JonathanGWesterfield/CSCE462/Project Files/AutoSpiel Images/JPG's/In Lab.jpg

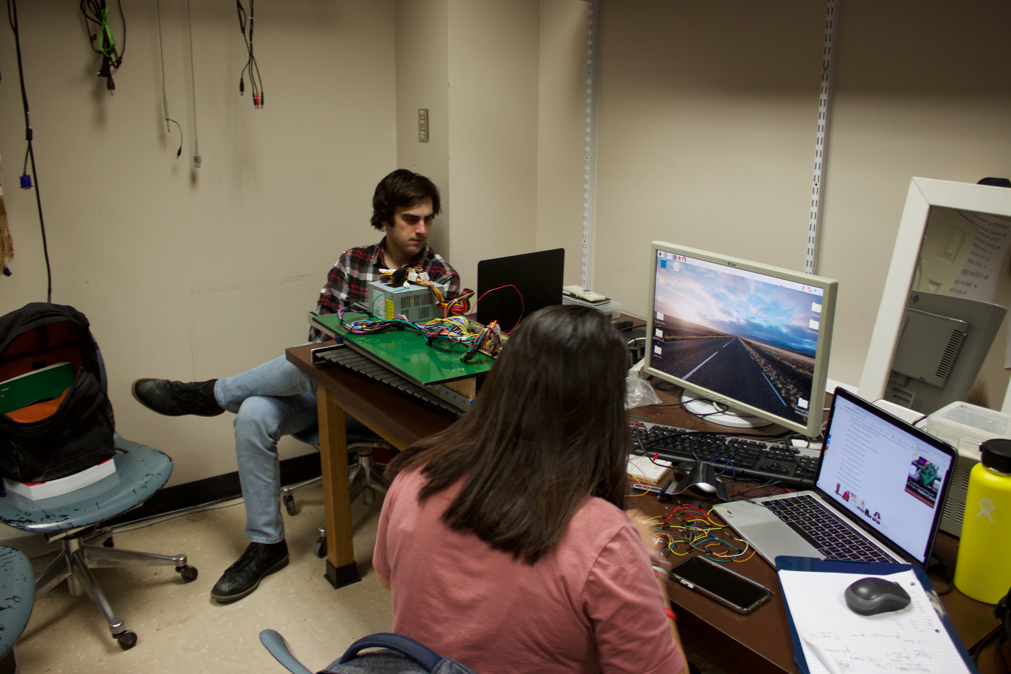
Project Files/AutoSpiel Images/JPG's/In Lab.jpg
