JonathanGWesterfield/CSCE462/Project Files/AutoSpiel Images/JPG's/IMG_7271.jpg

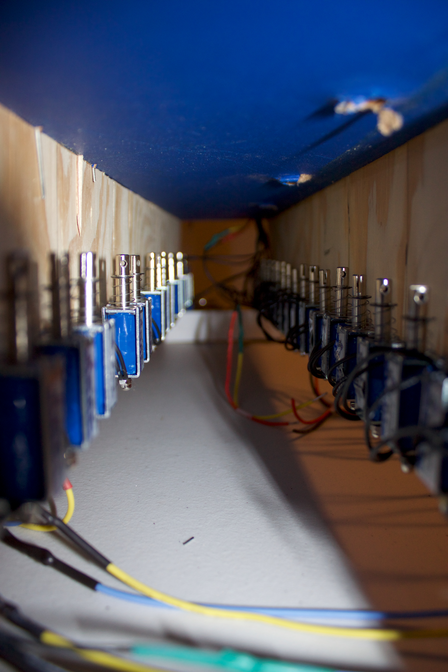
Project Files/AutoSpiel Images/JPG's/IMG_7271.jpg
