JonathanGWesterfield/CSCE462/README.md

# CSCE 462

Repo to store all lab assignments and eventually the project code for this class

# Wiki Page for this repository can be found here:
[AutoSpiel Wiki Page](https://github.com/JonathanGWesterfield/CSCE462/wiki/Project-Outline "AutoSpiel Wiki Page")
