JonathanGWesterfield/CSCE462/Project Files/PCB Layouts/README.md

# Important Info
* The AutoSpiel board schematics and layout files are in the AutoSpiel Folder
* The Texas A&M Fischer Design Center has strict rules about the minimum requirements that can be submitted for PCB fabrication
    * You must use their DRC file in order to conform to their specifications
    * WARNING: the FEDC was pretty terrible this semester (Fall 2018) and the PCB had numerous fabrication mistakes
