JonathanGWesterfield/CSCE462/Project Files/RPi_FileHandling/README.md

# Objective
This folder is for the files related to the serial communication between 
the Raspberry Pi and the Nu32. The RPi will take the JSON data and then use the files within this folder to transfer the data to the 
Nu32 microcontroller.
