JonathanGWesterfield/CSCE462/Project Files/RPi_FileHandling/FinalProjectFiles/info.txt

File handler with play/pause, next and previous functionalities with the Raspberry Pi 3
This code is run in Python3.
