JonathanGWesterfield/CSCE462/Labs/Lab5/figure_1.png

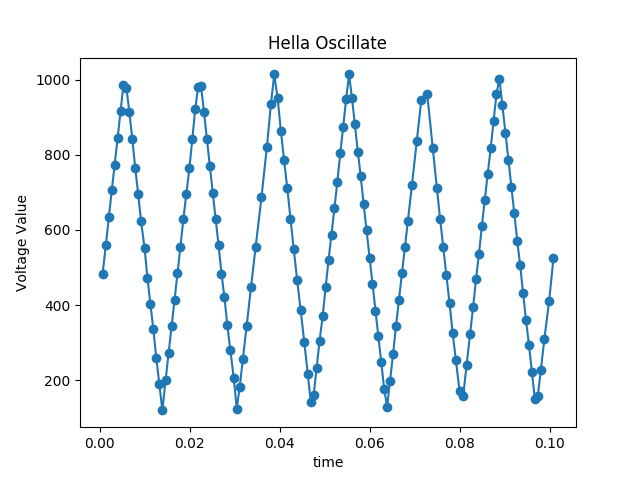
Labs/Lab5/figure_1.png
