JonathanGWesterfield/CSCE462/Labs/Lab5/sin.png

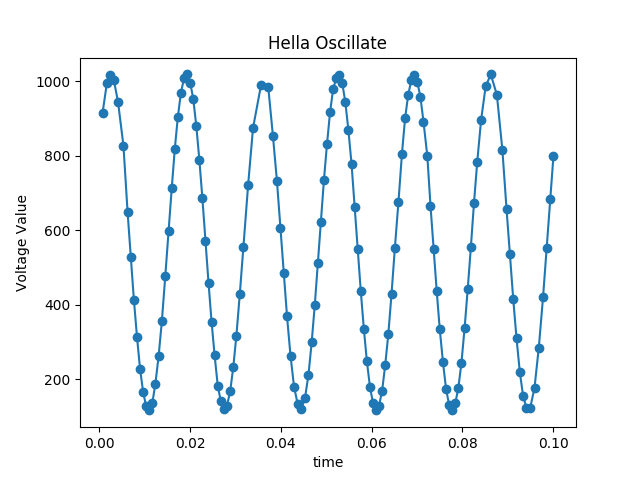
Labs/Lab5/sin.png
