JonathanGWesterfield/CSCE462/Labs/Lab5/square.png

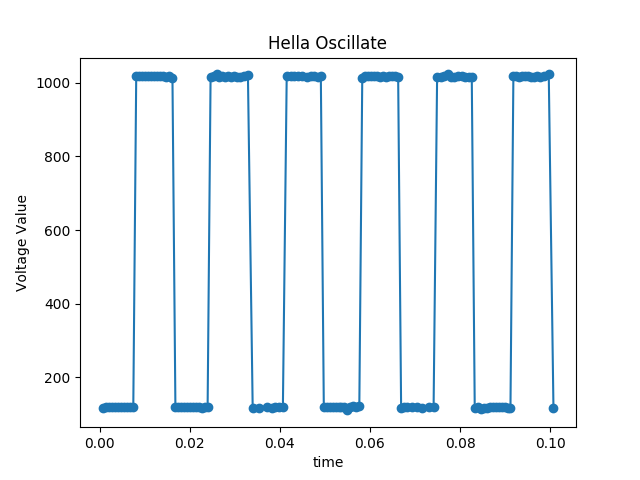
Labs/Lab5/square.png
