JonathanGWesterfield/CSCE462/Project Files/AutoSpiel Images/AutoSpiel Board.png

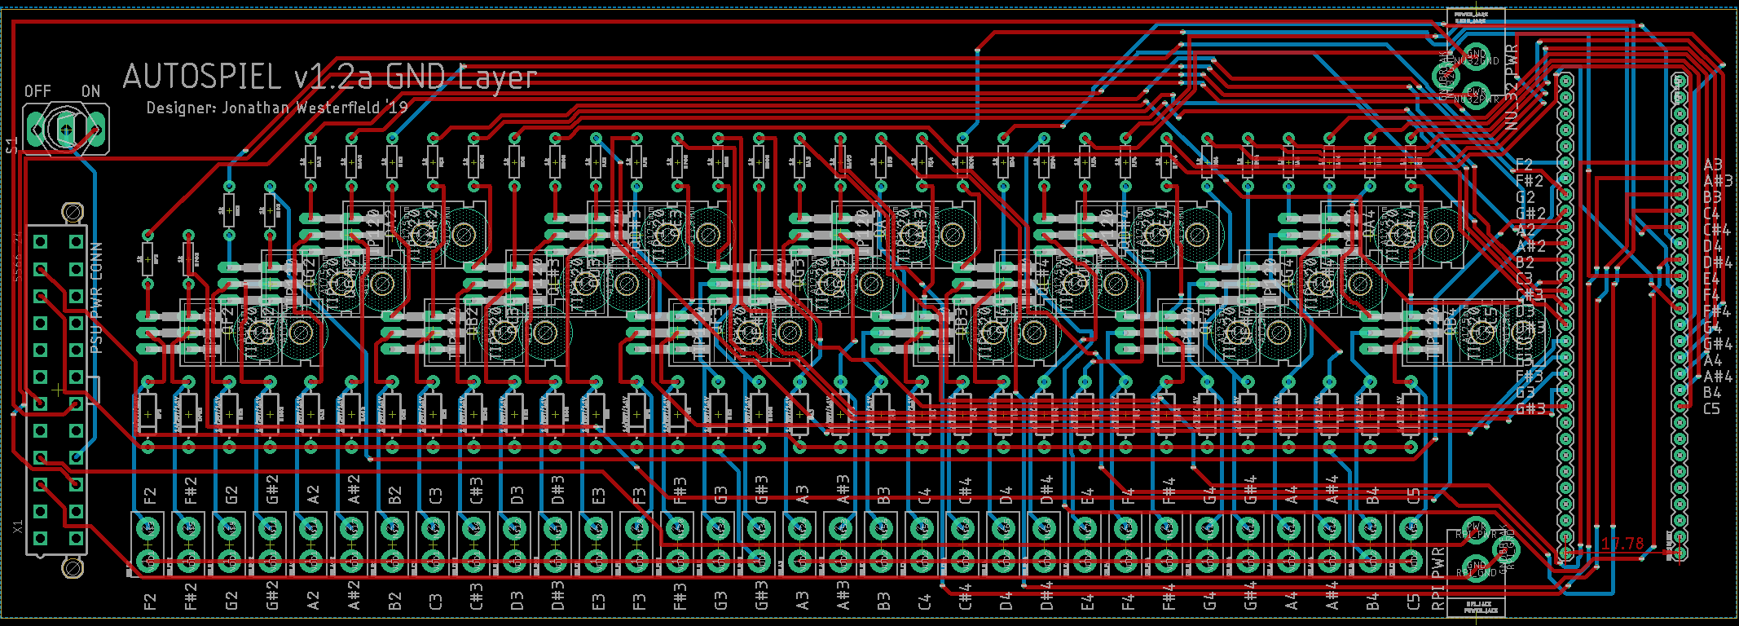
Project Files/AutoSpiel Images/AutoSpiel Board.png
