JonathanGWesterfield/CSCE462/Project Files/AutoSpiel Images/AutoSpiel Schematic.png

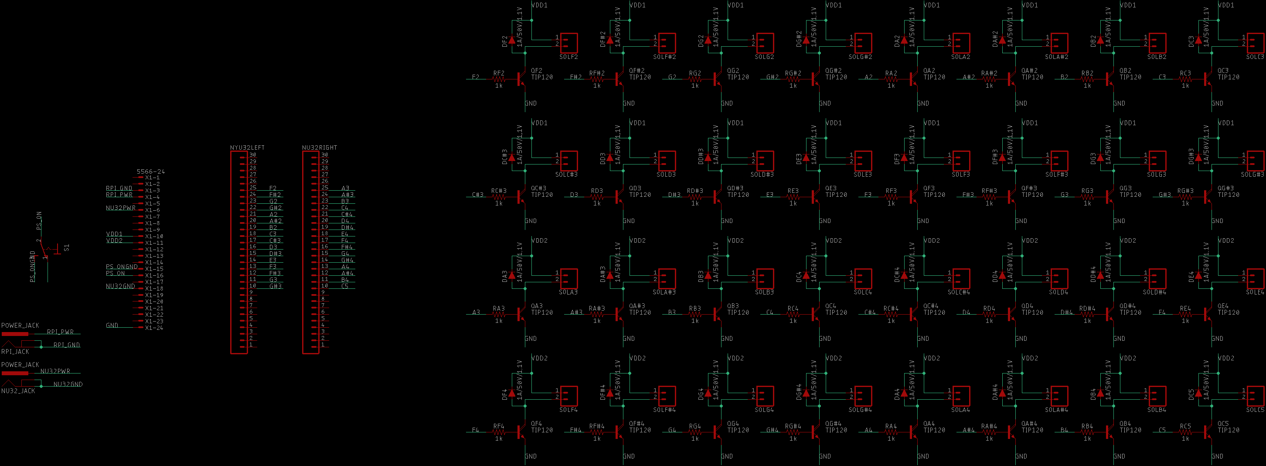
Project Files/AutoSpiel Images/AutoSpiel Schematic.png
