JonathanGWesterfield/CSCE462/Project Files/AutoSpiel Images/JPG's/Exploded Transistor.jpg

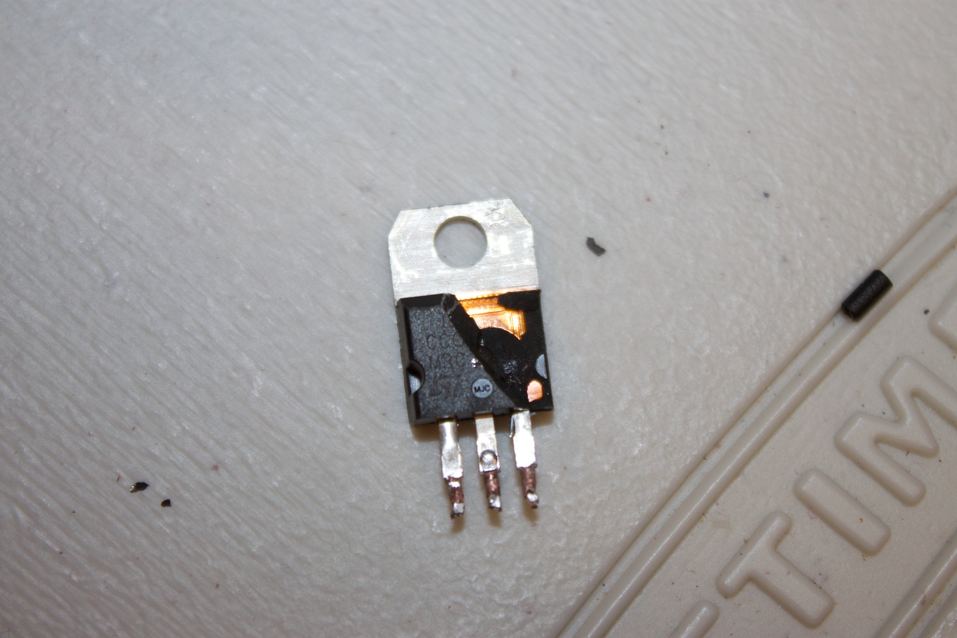
Project Files/AutoSpiel Images/JPG's/Exploded Transistor.jpg
