JonathanGWesterfield/CSCE462/Project Files/AutoSpiel Images/JPG's/Glamour Shot 2.jpg

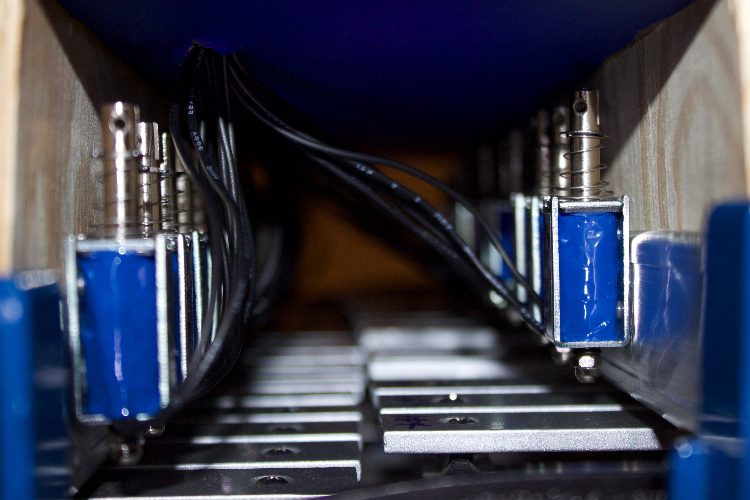
Project Files/AutoSpiel Images/JPG's/Glamour Shot 2.jpg
