JonathanGWesterfield/CSCE462/Project Files/AutoSpiel Images/JPG's/IMG_7268.jpg

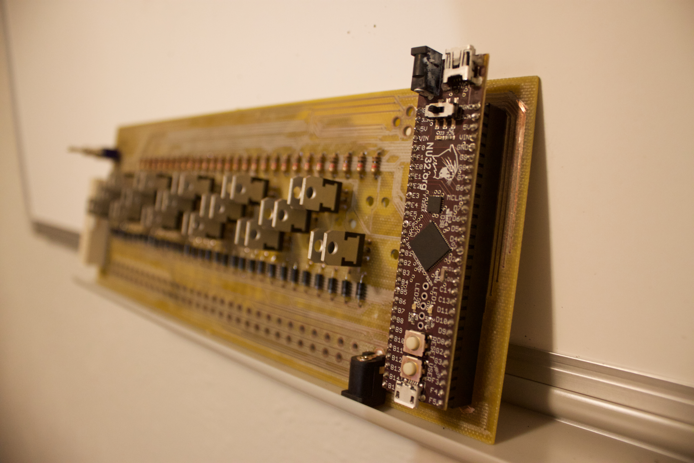
Project Files/AutoSpiel Images/JPG's/IMG_7268.jpg
