JonathanGWesterfield/CSCE462/Project Files/AutoSpiel Images/JPG's/IMG_7270.jpg

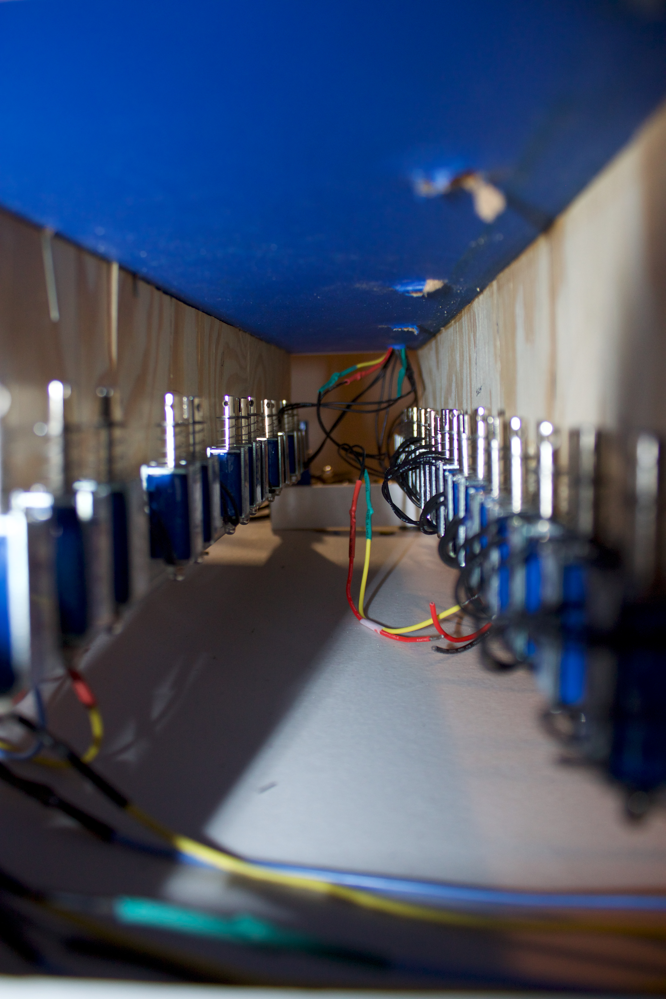
Project Files/AutoSpiel Images/JPG's/IMG_7270.jpg
