JonathanGWesterfield/CSCE462/Project Files/AutoSpiel Images/JPG's/Team Photo 3.jpg

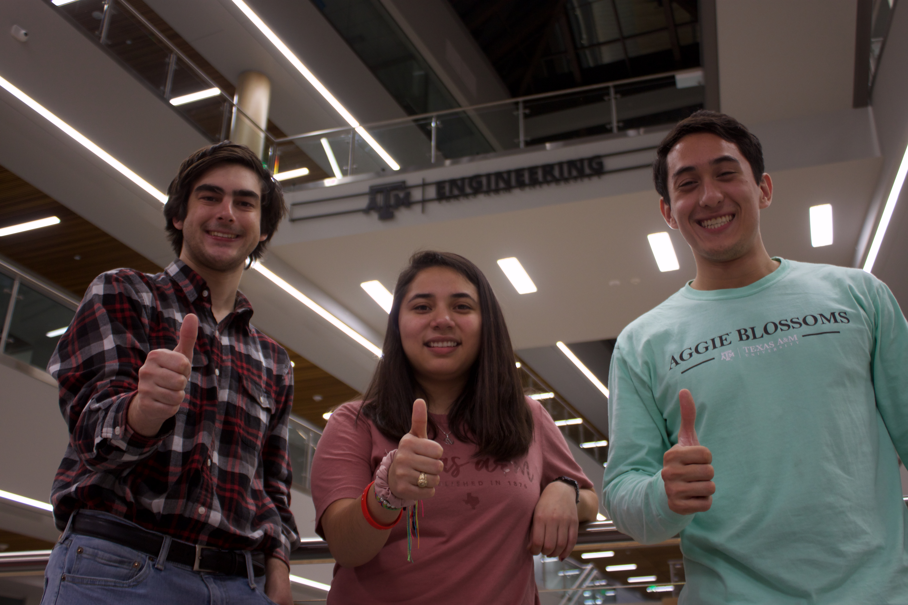
Project Files/AutoSpiel Images/JPG's/Team Photo 3.jpg
