JonathanGWesterfield/CSCE462/Project Files/AutoSpiel Images/JPG's/Team Photo 4.jpg

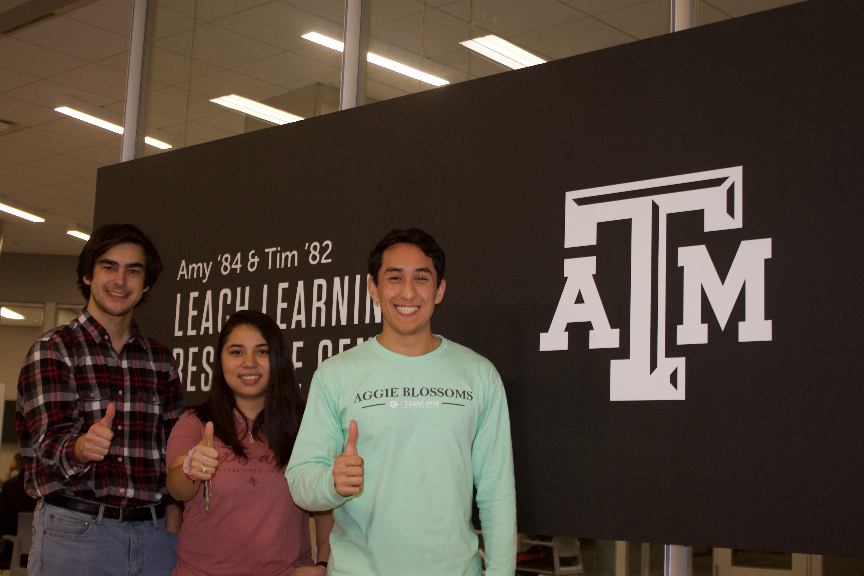
Project Files/AutoSpiel Images/JPG's/Team Photo 4.jpg
