JonathanGWesterfield/CSCE462/Project Files/AutoSpiel Images/Solenoid Circuit.png

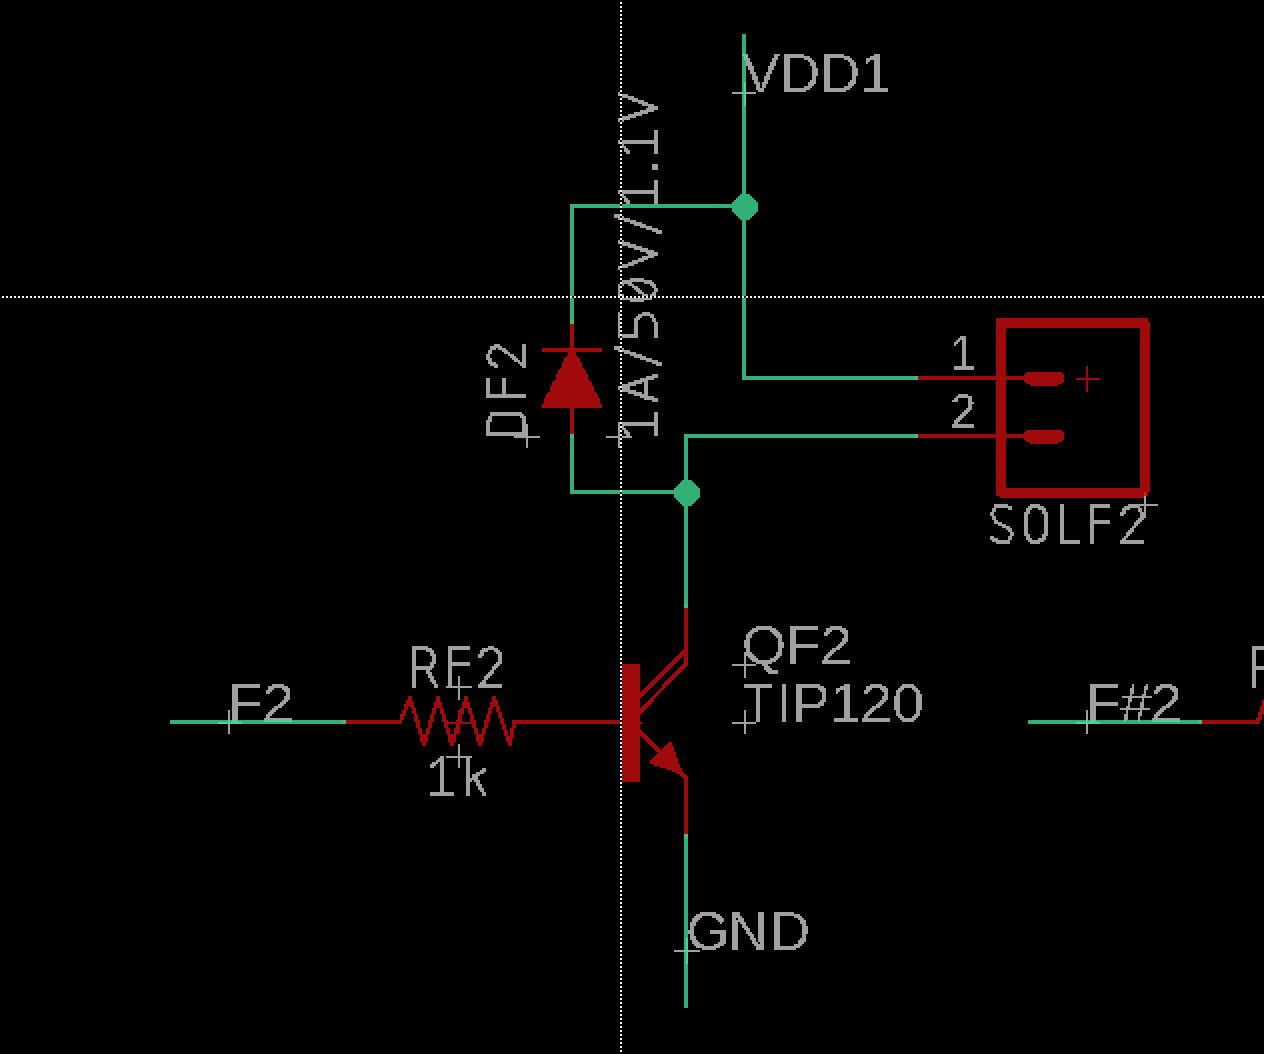
Project Files/AutoSpiel Images/Solenoid Circuit.png
