JonathanGWesterfield/CSCE462/Project Files/Piano Parts.xlsx

Piano Project
 |  |  |  |  |  | Due Date: | November 30?
Parts List Large |  | Parts Quantities | Parts Unit Cost | Parts Total Cost | Lead Time | Estimated construction time: | 1 Month
 | solenoids | 70 | 2.6 | 182 | 2 weeks for all | Get Project Approval?
 | Transistors | 70 | 0.4 | 28
 | Copper Plate (6x12) | 4 | 16.5 | 66
 | Etching Solution (Ferric Chloride acid) | 1 L | 18 | 18
 | 18 Gauge Wire | 100ft | 19 | 19
 | USB Bitwhacker | 1 | 40 | 40
 | Solder wire | 3 | 7.29 | 21.87
 | MDF | Unknown
 | Aluminum braces (bars) | Unknown
 |  |  |  | 374.87
Parts List Small |  | Parts Quantities | Part Cost | Parts Total Cost | Lead Time
 | solenoids | 32 | 2.6 | 83.2
 | Transistors | 32 | 0.4 | 12.8
 | Copper Plate (4x12) | 2 | 16.5 | 33
 | Etching Solution (Ferric Chloride acid) | 1 L | 18 | 18
 | 18 Gauge Wire | 100 ft | 19 | 19
 | USB Bitwhacker | 1 | 40 | 40
 | Solder wire | 2 | 7.29 | 14.58
 | MDF | Unknown
 | Aluminum braces (bars) | Unknown
 |  |  |  | 220.58
Research Subjects:
 | Research MIDI Files
 | Research I/O with bithwhacker
 | Research Serial communication between PI and USBW
 | Research what languages to use
 | People need to learn to solder
 | Who has strengths in what areas
 | Research how to layout a PCB
 | Research how to make a PCB
