JonathanGWesterfield/CSCE462/Project Files/PCB Layouts/AutoSpiel/AutoSpielSimplified.brd

## EAGLE design Project Files/PCB Layouts/AutoSpiel/AutoSpielSimplified.brd (2018-10-30)

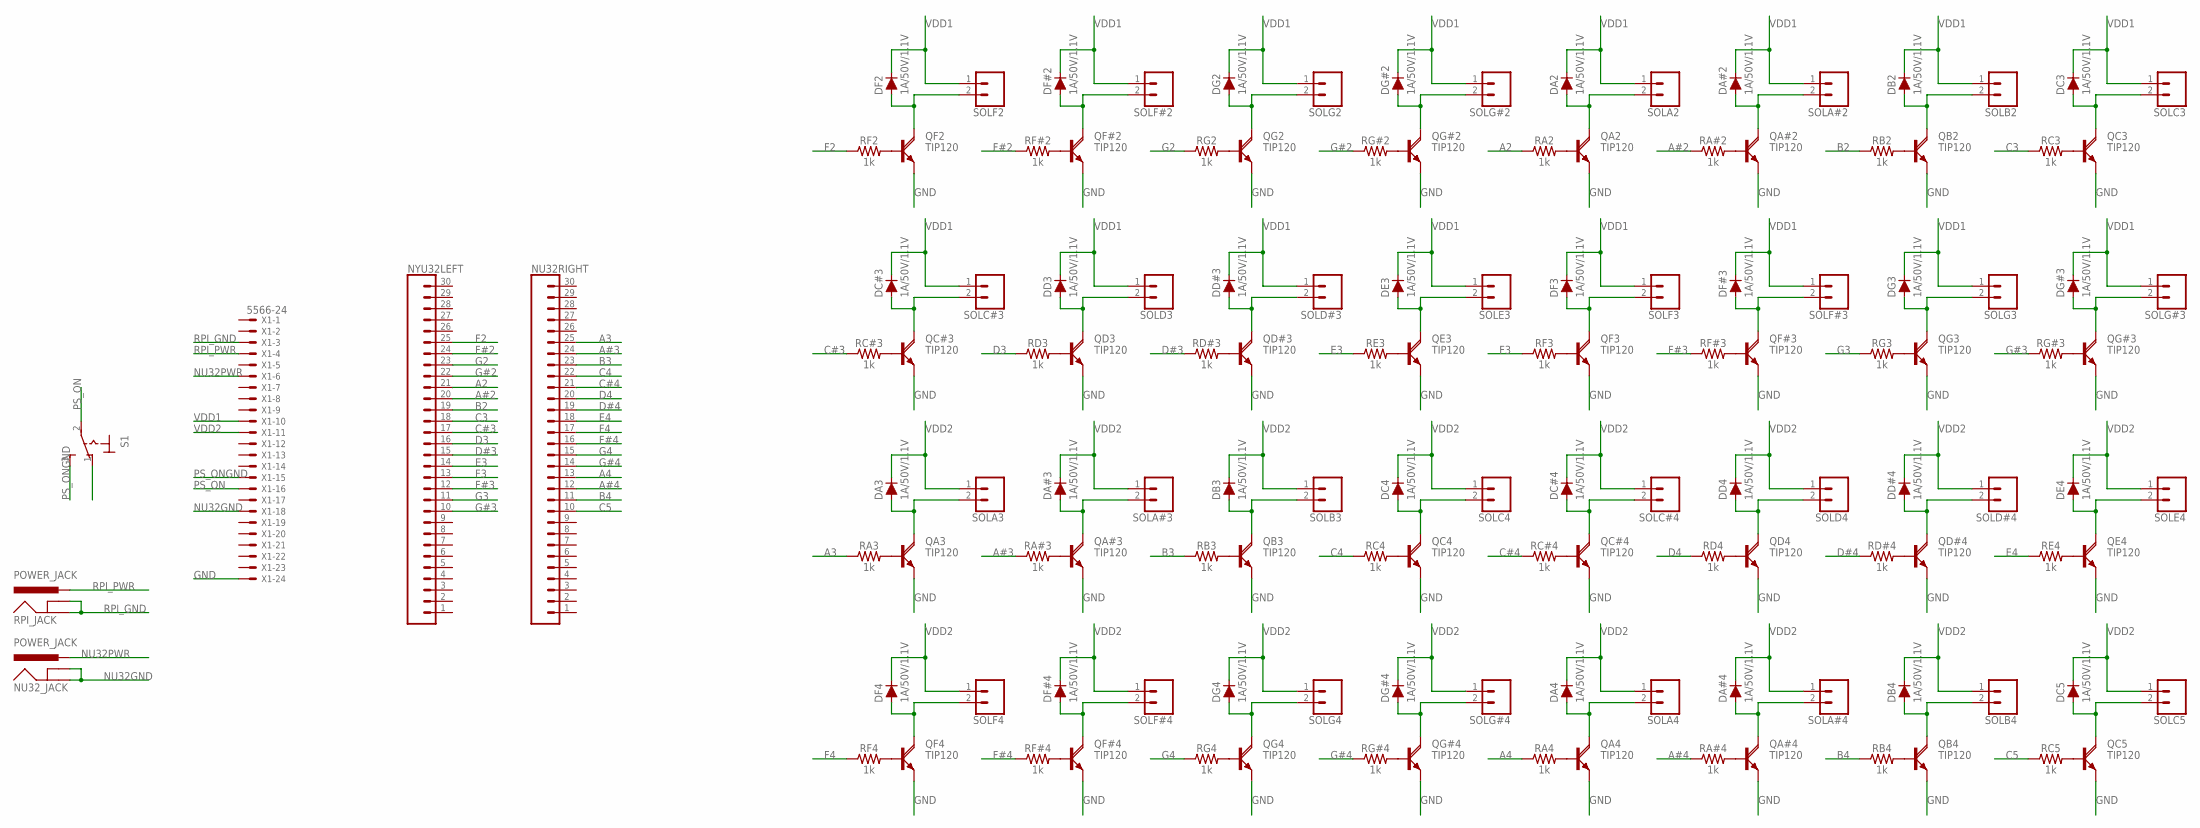
[picture p15: schematic AutoSpielSimplified.sch]

Parts:
DA2, DA3, DA4: 1A/50V/1.1V; DIODE-1N4001
DA#2, DA#3, DA#4: 1A/50V/1.1V; DIODE-1N4001
DB2, DB3, DB4: 1A/50V/1.1V; DIODE-1N4001
DC3, DC4, DC5: 1A/50V/1.1V; DIODE-1N4001
DC#3, DC#4: 1A/50V/1.1V; DIODE-1N4001
DD3, DD4: 1A/50V/1.1V; DIODE-1N4001
DD#3, DD#4: 1A/50V/1.1V; DIODE-1N4001
DE3, DE4: 1A/50V/1.1V; DIODE-1N4001
DF2, DF3, DF4: 1A/50V/1.1V; DIODE-1N4001
DF#2, DF#3, DF#4: 1A/50V/1.1V; DIODE-1N4001
DG2, DG3, DG4: 1A/50V/1.1V; DIODE-1N4001
DG#2, DG#3, DG#4: 1A/50V/1.1V; DIODE-1N4001
NU32RIGHT: CONN_30; 1X30
NU32_JACK: POWER_JACK; POWER_JACK_PTH
NYU32LEFT: CONN_30; 1X30
QA2, QA3, QA4: TIP120; TO220AH
QA#2, QA#3, QA#4: TIP120; TO220AH
QB2, QB3, QB4: TIP120; TO220AH
QC3, QC4, QC5: TIP120; TO220AH
QC#3, QC#4: TIP120; TO220AH
QD3, QD4: TIP120; TO220AH
QD#3, QD#4: TIP120; TO220AH
QE3, QE4: TIP120; TO220AH
QF2, QF3, QF4: TIP120; TO220AH
QF#2, QF#3, QF#4: TIP120; TO220AH
QG2, QG3, QG4: TIP120; TO220AH
QG#2, QG#3, QG#4: TIP120; TO220AH
RA2, RA3, RA4: 1k; AXIAL-0.3
RA#2, RA#3, RA#4: 1k; AXIAL-0.3
RB2, RB3, RB4: 1k; AXIAL-0.3
RC3, RC4, RC5: 1k; AXIAL-0.3
RC#3, RC#4: 1k; AXIAL-0.3
RD3, RD4: 1k; AXIAL-0.3
RD#3, RD#4: 1k; AXIAL-0.3
RE3, RE4: 1k; AXIAL-0.3
RF2, RF3, RF4: 1k; AXIAL-0.3
RF#2, RF#3, RF#4: 1k; AXIAL-0.3
RG2, RG3, RG4: 1k; AXIAL-0.3
RG#2, RG#3, RG#4: 1k; AXIAL-0.3
RPI_JACK: POWER_JACK; POWER_JACK_PTH
S1: M9040P
SOLA2, SOLA3, SOLA4: CONN_02PTH4; 1X02_XTRA_BIG
SOLA#2, SOLA#3, SOLA#4: CONN_02PTH4; 1X02_XTRA_BIG
SOLB2, SOLB3, SOLB4: CONN_02PTH4; 1X02_XTRA_BIG
SOLC3, SOLC4, SOLC5: CONN_02PTH4; 1X02_XTRA_BIG
SOLC#3, SOLC#4: CONN_02PTH4; 1X02_XTRA_BIG
SOLD3, SOLD4: CONN_02PTH4; 1X02_XTRA_BIG
SOLD#3, SOLD#4: CONN_02PTH4; 1X02_XTRA_BIG
SOLE3, SOLE4: CONN_02PTH4; 1X02_XTRA_BIG
SOLF2, SOLF3, SOLF4: CONN_02PTH4; 1X02_XTRA_BIG
SOLF#2, SOLF#3, SOLF#4: CONN_02PTH4; 1X02_XTRA_BIG
SOLG2, SOLG3, SOLG4: CONN_02PTH4; 1X02_XTRA_BIG
SOLG#2, SOLG#3, SOLG#4: CONN_02PTH4; 1X02_XTRA_BIG
X1: 5566-24

Connections:
A2: NYU32LEFT.21, RA2.P$1 (1)
A3: NU32RIGHT.25, RA3.P$1 (1)
A4: NU32RIGHT.13, RA4.P$1 (1)
A#2: NYU32LEFT.20, RA#2.P$1 (1)
A#3: NU32RIGHT.24, RA#3.P$1 (1)
A#4: NU32RIGHT.12, RA#4.P$1 (1)
B2: NYU32LEFT.19, RB2.P$1 (1)
B3: NU32RIGHT.23, RB3.P$1 (1)
B4: NU32RIGHT.11, RB4.P$1 (1)
C3: NYU32LEFT.18, RC3.P$1 (1)
C4: NU32RIGHT.22, RC4.P$1 (1)
C5: NU32RIGHT.10, RC5.P$1 (1)
C#3: NYU32LEFT.17, RC#3.P$1 (1)
C#4: NU32RIGHT.21, RC#4.P$1 (1)
D3: NYU32LEFT.16, RD3.P$1 (1)
D4: NU32RIGHT.20, RD4.P$1 (1)
D#3: NYU32LEFT.15, RD#3.P$1 (1)
D#4: NU32RIGHT.19, RD#4.P$1 (1)
E3: NYU32LEFT.14, RE3.P$1 (1)
E4: NU32RIGHT.18, RE4.P$1 (1)
F2: NYU32LEFT.25, RF2.P$1 (1)
F3: NYU32LEFT.13, RF3.P$1 (1)
F4: NU32RIGHT.17, RF4.P$1 (1)
F#2: NYU32LEFT.24, RF#2.P$1 (1)
F#3: NYU32LEFT.12, RF#3.P$1 (1)
F#4: NU32RIGHT.16, RF#4.P$1 (1)
G2: NYU32LEFT.23, RG2.P$1 (1)
G3: NYU32LEFT.11, RG3.P$1 (1)
G4: NU32RIGHT.15, RG4.P$1 (1)
G#2: NYU32LEFT.22, RG#2.P$1 (1)
G#3: NYU32LEFT.10, RG#3.P$1 (1)
G#4: NU32RIGHT.14, RG#4.P$1 (1)
GND: QA2.E, QA3.E, QA4.E, QA#2.E, QA#3.E, QA#4.E, QB2.E, QB3.E, QB4.E, QC3.E, QC4.E, QC5.E, QC#3.E, QC#4.E, QD3.E, QD4.E, QD#3.E, QD#4.E, QE3.E, QE4.E, QF2.E, QF3.E, QF4.E, QF#2.E, QF#3.E, QF#4.E, QG2.E, QG3.E, QG4.E, QG#2.E, QG#3.E, QG#4.E, X1.24
unnamed: QF2.B, RF2.P$2 (2)
unnamed: QC#3.B, RC#3.P$2 (2)
unnamed: DF2.A, QF2.C, SOLF2.2
unnamed: QF#2.B, RF#2.P$2 (2)
unnamed: DF#2.A, QF#2.C, SOLF#2.2
unnamed: DC#3.A, QC#3.C, SOLC#3.2
unnamed: QG2.B, RG2.P$2 (2)
unnamed: DG2.A, QG2.C, SOLG2.2
unnamed: QD3.B, RD3.P$2 (2)
unnamed: QG#2.B, RG#2.P$2 (2)
unnamed: DG#2.A, QG#2.C, SOLG#2.2
unnamed: DD3.A, QD3.C, SOLD3.2
unnamed: QA2.B, RA2.P$2 (2)
unnamed: DA2.A, QA2.C, SOLA2.2
unnamed: QD#3.B, RD#3.P$2 (2)
unnamed: QA#2.B, RA#2.P$2 (2)
unnamed: DA#2.A, QA#2.C, SOLA#2.2
unnamed: DD#3.A, QD#3.C, SOLD#3.2
unnamed: QB2.B, RB2.P$2 (2)
unnamed: DB2.A, QB2.C, SOLB2.2
unnamed: QE3.B, RE3.P$2 (2)
unnamed: QC3.B, RC3.P$2 (2)
unnamed: DC3.A, QC3.C, SOLC3.2
unnamed: DE3.A, QE3.C, SOLE3.2
unnamed: QA3.B, RA3.P$2 (2)
unnamed: DA3.A, QA3.C, SOLA3.2
unnamed: QF3.B, RF3.P$2 (2)
unnamed: DF3.A, QF3.C, SOLF3.2
unnamed: QF#3.B, RF#3.P$2 (2)
unnamed: DF#3.A, QF#3.C, SOLF#3.2
unnamed: QG3.B, RG3.P$2 (2)
unnamed: DG3.A, QG3.C, SOLG3.2
unnamed: QG#3.B, RG#3.P$2 (2)
unnamed: DG#3.A, QG#3.C, SOLG#3.2
unnamed: QF4.B, RF4.P$2 (2)
unnamed: DF4.A, QF4.C, SOLF4.2
unnamed: QF#4.B, RF#4.P$2 (2)
unnamed: DF#4.A, QF#4.C, SOLF#4.2
unnamed: QG4.B, RG4.P$2 (2)
unnamed: DG4.A, QG4.C, SOLG4.2
unnamed: QG#4.B, RG#4.P$2 (2)
unnamed: DG#4.A, QG#4.C, SOLG#4.2
unnamed: QA4.B, RA4.P$2 (2)
unnamed: DA4.A, QA4.C, SOLA4.2
unnamed: QA#4.B, RA#4.P$2 (2)
unnamed: DA#4.A, QA#4.C, SOLA#4.2
unnamed: QB4.B, RB4.P$2 (2)
unnamed: DB4.A, QB4.C, SOLB4.2
unnamed: QC5.B, RC5.P$2 (2)
unnamed: DC5.A, QC5.C, SOLC5.2
unnamed: QA#3.B, RA#3.P$2 (2)
unnamed: DA#3.A, QA#3.C, SOLA#3.2
unnamed: QB3.B, RB3.P$2 (2)
unnamed: DB3.A, QB3.C, SOLB3.2
unnamed: QC4.B, RC4.P$2 (2)
unnamed: DC4.A, QC4.C, SOLC4.2
unnamed: QC#4.B, RC#4.P$2 (2)
unnamed: DC#4.A, QC#4.C, SOLC#4.2
unnamed: QD4.B, RD4.P$2 (2)
unnamed: DD4.A, QD4.C, SOLD4.2
unnamed: QD#4.B, RD#4.P$2 (2)
unnamed: DD#4.A, QD#4.C, SOLD#4.2
unnamed: QE4.B, RE4.P$2 (2)
unnamed: DE4.A, QE4.C, SOLE4.2
NU32GND: NU32_JACK.GND, NU32_JACK.GNDBREAK, X1.18
NU32PWR: NU32_JACK.PWR, X1.6
PS_ON: S1.2, X1.16
PS_ONGND: S1.3 (S), X1.15
RPI_GND: RPI_JACK.GND, RPI_JACK.GNDBREAK, X1.3
RPI_PWR: RPI_JACK.PWR, X1.4
VDD1: DA2.C, DA#2.C, DB2.C, DC3.C, DC#3.C, DD3.C, DD#3.C, DE3.C, DF2.C, DF3.C, DF#2.C, DF#3.C, DG2.C, DG3.C, DG#2.C, DG#3.C, SOLA2.1, SOLA#2.1, SOLB2.1, SOLC3.1, SOLC#3.1, SOLD3.1, SOLD#3.1, SOLE3.1, SOLF2.1, SOLF3.1, SOLF#2.1, SOLF#3.1, SOLG2.1, SOLG3.1, SOLG#2.1, SOLG#3.1, X1.10
VDD2: DA3.C, DA4.C, DA#3.C, DA#4.C, DB3.C, DB4.C, DC4.C, DC5.C, DC#4.C, DD4.C, DD#4.C, DE4.C, DF4.C, DF#4.C, DG4.C, DG#4.C, SOLA3.1, SOLA4.1, SOLA#3.1, SOLA#4.1, SOLB3.1, SOLB4.1, SOLC4.1, SOLC5.1, SOLC#4.1, SOLD4.1, SOLD#4.1, SOLE4.1, SOLF4.1, SOLF#4.1, SOLG4.1, SOLG#4.1, X1.11

Board: 2 copper layers, 134 parts (0 on the bottom side), 105 nets, no tracks yet.
