JonathanGWesterfield/CSCE462/Project Files/PCB Layouts/AutoSpiel/AutoSpiel.brd

## EAGLE design Project Files/PCB Layouts/AutoSpiel/AutoSpiel.brd (2018-10-19)

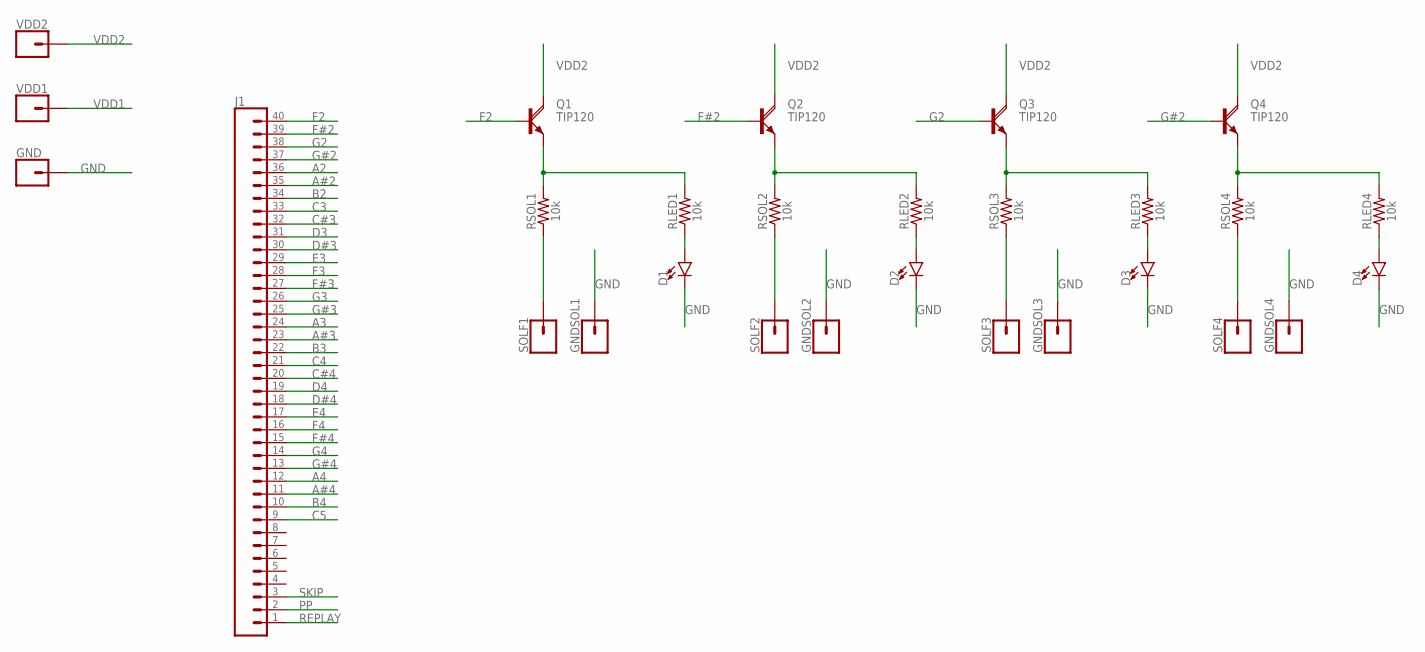
[picture p16: schematic AutoSpiel.sch]

Parts:
D1, D2, D3, D4: LED3MM; LED_3MM
GND: CONN_01; 1X01
GNDSOL1, GNDSOL2, GNDSOL3, GNDSOL4: CONN_01; 1X01
J1: CONN_40; 1X40
Q1, Q2, Q3, Q4: TIP120; TO220AH
RLED1, RLED2, RLED3, RLED4: 10k; AXIAL-0.3-KIT
RSOL1, RSOL2, RSOL3, RSOL4: 10k; AXIAL-0.3-KIT
SOLF1, SOLF2, SOLF3, SOLF4: CONN_01; 1X01
VDD1, VDD2: CONN_01; 1X01

Connections:
A2: J1.36
A3: J1.24
A4: J1.12
A#2: J1.35
A#3: J1.23
A#4: J1.11
B2: J1.34
B3: J1.22
B4: J1.10
C3: J1.33
C4: J1.21
C5: J1.9
C#3: J1.32
C#4: J1.20
D3: J1.31
D4: J1.19
D#3: J1.30
D#4: J1.18
E3: J1.29
E4: J1.17
F2: J1.40, Q1.B
F3: J1.28
F4: J1.16
F#2: J1.39, Q2.B
F#3: J1.27
F#4: J1.15
G2: J1.38, Q3.B
G3: J1.26
G4: J1.14
G#2: J1.37, Q4.B
G#3: J1.25
G#4: J1.13
GND: D1.K (C), D2.K (C), D3.K (C), D4.K (C), GND.1, GNDSOL1.1, GNDSOL2.1, GNDSOL3.1, GNDSOL4.1
unnamed: Q2.E, RLED2.P$2 (2), RSOL2.P$2 (2)
unnamed: RSOL2.P$1 (1), SOLF2.1
unnamed: D2.A, RLED2.P$1 (1)
unnamed: Q3.E, RLED3.P$2 (2), RSOL3.P$2 (2)
unnamed: RSOL3.P$1 (1), SOLF3.1
unnamed: Q1.E, RLED1.P$2 (2), RSOL1.P$2 (2)
unnamed: D3.A, RLED3.P$1 (1)
unnamed: Q4.E, RLED4.P$2 (2), RSOL4.P$2 (2)
unnamed: RSOL4.P$1 (1), SOLF4.1
unnamed: D4.A, RLED4.P$1 (1)
unnamed: RSOL1.P$1 (1), SOLF1.1
unnamed: D1.A, RLED1.P$1 (1)
PP: J1.2
REPLAY: J1.1
SKIP: J1.3
VDD1: VDD1.1
VDD2: Q1.C, Q2.C, Q3.C, Q4.C, VDD2.1

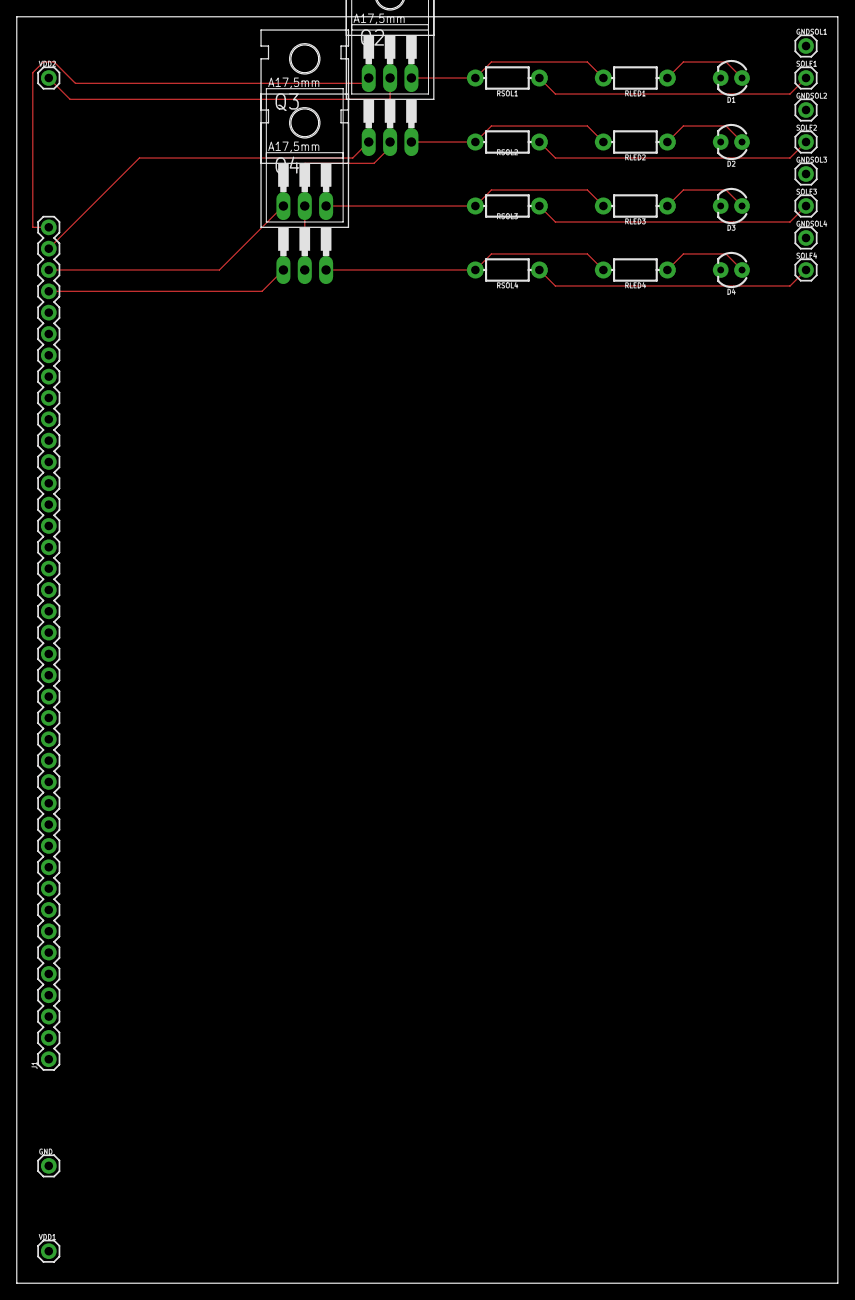
[picture p17: board AutoSpiel.brd from above]

Board: 2 copper layers, 97.8 x 150.8 mm, 28 parts (0 on the bottom side), 18 nets.
