JonathanGWesterfield/CSCE462/Project Files/RPi_FileHandling/SampleProgram/indexNotes.py

def indexing(N):
    if N == 'C5':
        return 0b00000000000000000000000000000001
    elif N == 'B4':
        return 0b00000000000000000000000000000010
    elif N == 'D#1':
        return 0b00000000000000000000000000000100
    elif N == 'A4':
        return 0b00000000000000000000000000001000
    elif N == 'D3#':
        return 0b00000000000000000000000000010000
    elif N == 'G4':
        return 0b00000000000000000000000000100000
    elif N == 'D#5':
        return 0b00000000000000000000000001000000
    elif N == 'F4':
        return 0b00000000000000000000000010000000
    elif N == 'E4':
        return 0b00000000000000000000000100000000
    elif N == 'B#1':
        return 0b00000000000000000000001000000000
    elif N == 'D4':
        return 0b00000000000000000000010000000000
    elif N == 'B#3':
        return 0b00000000000000000000100000000000
    elif N == 'C4':
        return 0b00000000000000000001000000000000
    elif N == 'B3':
        return 0b00000000000000000010000000000000
    elif N == 'B#6':
        return 0b00000000000000000100000000000000
    elif N == 'A3':
        return 0b00000000000000001000000000000000
    elif N == 'B8#':
        return 0b00000000000000010000000000000000
    elif N == 'G3':
        return 0b000000000000001000000000000000000
    elif N == 'B#10':
        return 0b00000000000001000000000000000000
    elif N == 'F3':
        return 0b00000000000010000000000000000000
    elif N == 'E3':
        return 0b00000000000100000000000000000000
    elif N == 'B#13':
        return 0b00000000001000000000000000000000
    elif N == 'D3':
        return 0b00000000010000000000000000000000
    elif N == 'B#15':
        return 0b00000000100000000000000000000000
    elif N == 'C3':
        return 0b00000001000000000000000000000000
    elif N == 'B2':
        return 0b00000010000000000000000000000000
    elif N == 'E#2':
        return 0b00000100000000000000000000000000
    elif N == 'A2':
        return 0b00001000000000000000000000000000
    elif N == 'E#4':
        return 0b00010000000000000000000000000000
    elif N == 'G2':
        return 0b00100000000000000000000000000000
    elif N == 'E5':
        return 0b01000000000000000000000000000000
    elif N == 'F2':
        return 0b10000000000000000000000000000000



def timerconv(S):
    return int((S / (12.5e-9 * 256)) - 1)
