JonathanGWesterfield/CSCE462/Labs/Lab2/PyDev/testSevSeg.py

from SevSeg import SevSeg
from time import sleep

seg = SevSeg()

seg.seg0()
sleep(1)

seg.seg1()
sleep(1)

seg.seg2()
sleep(1)

seg.seg3()
sleep(1)

seg.seg4()
sleep(1)

seg.seg5()
sleep(1)

seg.seg6()
sleep(1)

seg.seg7()
sleep(1)

seg.seg8()
sleep(1)

seg.seg9()
sleep(1)
