JonathanGWesterfield/CSCE462/(commit log)

2018-10-08 Added the cost chart for the piano project
    [Piano Parts.xlsx]
2018-10-08 Updated parts list and added the dummy project folder for lab 4
    [Piano Parts.xlsx, PianoMan.kicad_pcb, PianoMan.sch]
2018-10-09 Added documentation files for the UBW
    [UBW32_MX460_v262.brd, UBW32_MX460_v262.sch, UBW32_MX460_v262_Panel.brd]
2018-10-15 Reorganized files
    [Piano Parts.xlsx, PianoMan.kicad_pcb, PianoMan.sch, UBW32_MX460_v262.brd, UBW32_MX460_v262.sch, UBW32_MX460_v262_Panel.brd]
2018-10-16 Added some sample midi files
2018-10-18 fixed the frequency function in lab5 oscilloscope.py
    [oscilloscope.py]
2018-10-18 Added initial PCB files
    [AutoSpiel.brd, AutoSpiel.sch]
2018-10-19 Added more to the board to do fit testing
    [AutoSpiel.brd, AutoSpiel.sch]
2018-10-24 Added a couple of helpful pictures and redid the circuit based off of stuff I've researched
    [AutoSpiel.sch]
2018-10-25 Added a second schematic for a simplfied solenoid circuit (vs the one with a capacitor and PNP transistor in it)
    [AutoSpielSimplified.sch]
2018-10-26 Updated the simplified schematic
    [AutoSpielSimplified.sch]
2018-10-30 Reorganized folder structure for the microcontroller stuff and added a new textbook for the PIC32
    [UBW32_MX460_v262.brd, UBW32_MX460_v262.sch, UBW32_MX460_v262_Panel.brd]
2018-10-30 Added updated schematic for the autospiel
    [AutoSpielSimplified.sch]
2018-10-30 Finished schematic. Started board layout
    [AutoSpielSimplified.brd, AutoSpielSimplified.sch]
2018-10-30 Created 2 versions of the finished board
    [AutoSpielSimplified 2 Finished.brd, AutoSpielSimplified 2.brd, AutoSpielSimplified 2.sch, AutoSpielSimplified 3 Finished.brd, AutoSpielSimplified.brd]
2018-10-31 Labeled everything on the board layout
    [AutoSpielSimplified 2 Finished.brd]
2018-10-31 Added labels on the board
    [AutoSpielSimplified 3 Finished.brd]
2018-10-31 Added the rules for pcb printing at Tamu FEDC
2018-10-31 Created a board with the tamu FEDC DRC file
    [AutoSpiel v1.1b FEDC DRU.brd, AutoSpielSimplified 3 FEDC DRU.brd]
2018-11-03 Made 3 different versions of the pcb
    [AutoSpiel v1.1a.brd, AutoSpiel v1.2b FEDC DRU.brd, DRILEGEND.CFG]
2018-11-04 Added pinout of control board
2018-11-05 Finished and finalized Autospiel v1.3a. Created gerber files but need to confirm they are correct
    [AutoSpiel v1.2a.brd, AutoSpiel v1.3b FEDC DRU.brd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]
2018-11-06 Added updated FEDC files. Created new output gerber files for pcb fab
    [AutoSpiel v1.2a.brd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]
2018-11-27 Add files via upload
    Sample working program without serial communication
2018-12-03 Added the board schematics and layout as images
    [PianoMan.kicad_pcb, PianoMan.sch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]
2018-12-04 Removed unnecessary folders and moved files around
    [UBW32_MX460_v262.brd, UBW32_MX460_v262.sch, UBW32_MX460_v262_Panel.brd]
2018-12-04 Added Readmes to the PCB Layouts folder
2018-12-04 Moved the README for the PCB Layouts folder
